peverett/NeopixelTubeClock/NeopixelDisplayRingInstuctions.pdf

# Controller Display Ring

# INSTRUCTIONS

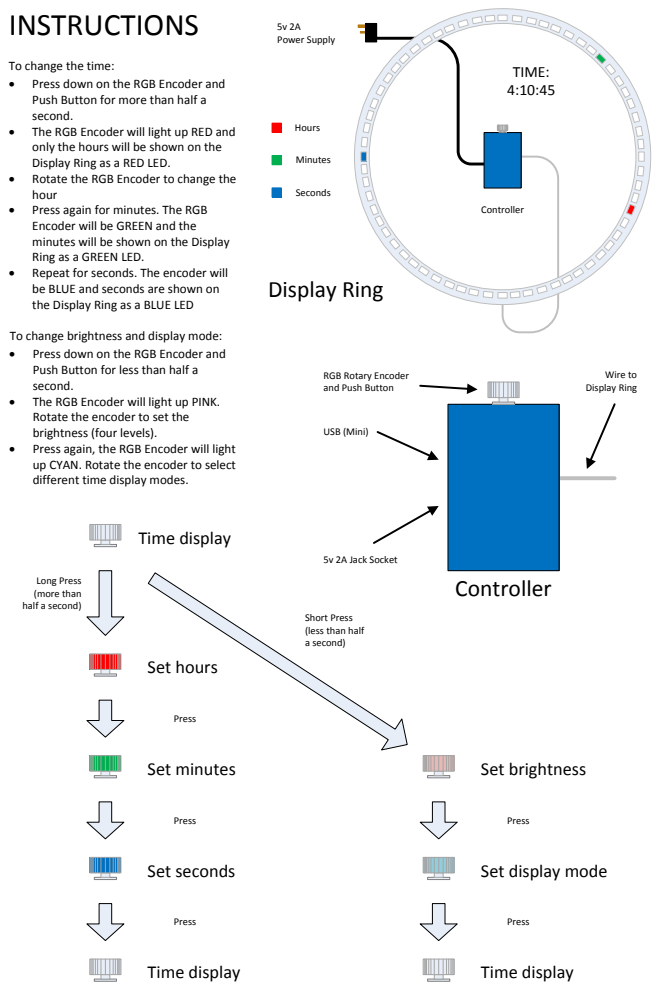
[picture p7: page 1]
5v 2A Power Supply; Hours; Minutes; Seconds; TIME: 4:10:45; USB (Mini); 5v 2A Jack Socket; RGB Rotary Encoder and Push Button; Wire to Display Ring; Controller; Set hours; Set minutes; Set seconds; Press; Time display; Set brightness; To change the time: ·; Press down on the RGB Encoder and; second. ·; The RGB Encoder will light up RED and; Display Ring as a RED LED. ·; Rotate the RGB Encoder to change the; hour ·; Press again for minutes. The RGB; Ring as a GREEN LED. ·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

Push Button for more than half a

only the hours will be shown on the

Encoder will be GREEN and the
minutes will be shown on the Display

be BLUE and seconds are shown on
the Display Ring as a BLUE LED

Push Button for less than half a

up CYAN. Rotate the encoder to select
different time display modes.

Long Press (more than half a second)

Short Press (less than half a second)

Set display mode
