peverett/NeopixelTubeClock/(commit log)

2018-03-25 Added seconds setup - simple cut & paste - maybe refactor.
2018-03-26 Improved encoder switch debounce.
